jsoeterbroek/handcrank/renders/crank_arm.png

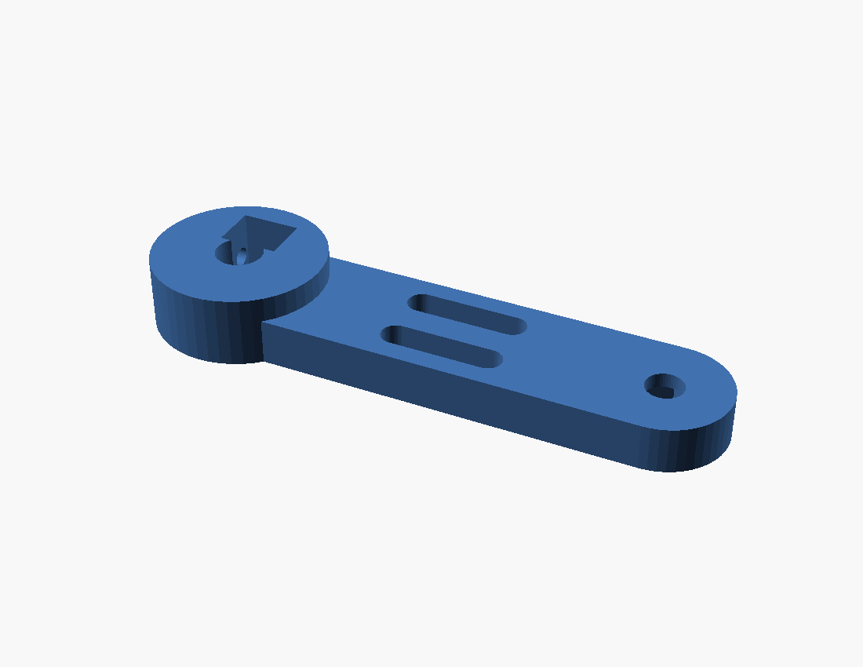
renders/crank_arm.png
