jsoeterbroek/handcrank/renders/crank_base.png

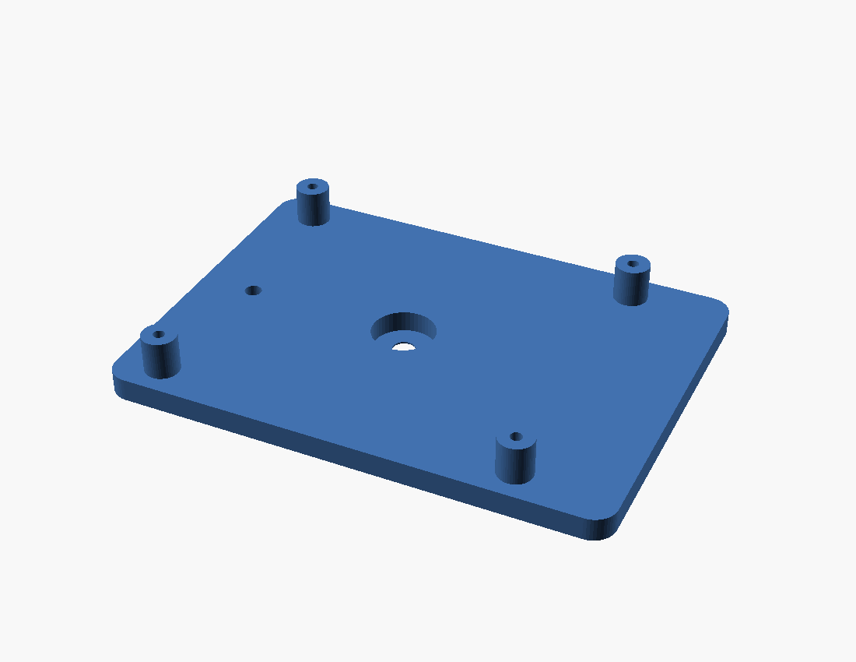
renders/crank_base.png
