jsoeterbroek/handcrank/renders/crank_gear_big.png

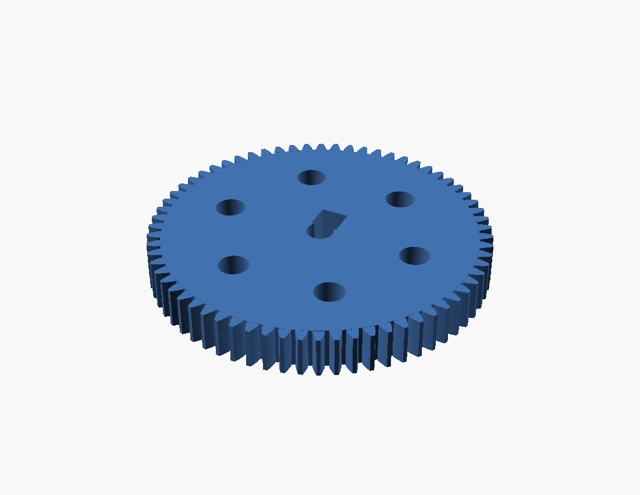
renders/crank_gear_big.png
