jsoeterbroek/handcrank/renders/crank_stator.png

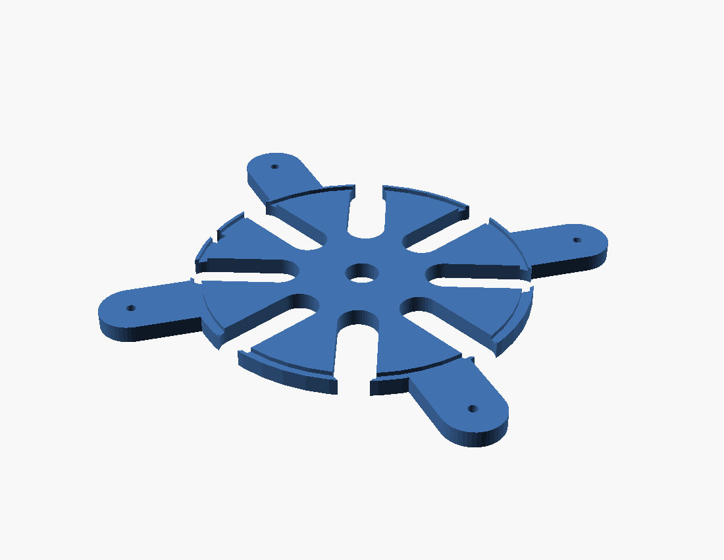
renders/crank_stator.png
