jsoeterbroek/handcrank/renders/crank_tray.png

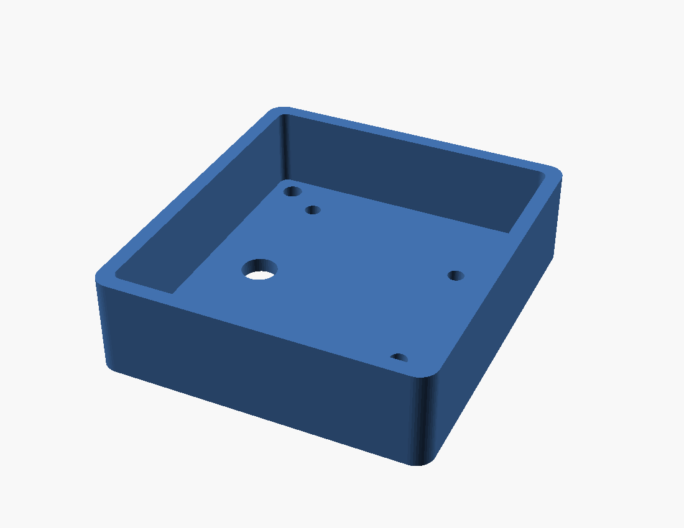
renders/crank_tray.png
