jsoeterbroek/handcrank/stl/handcrank.3mf

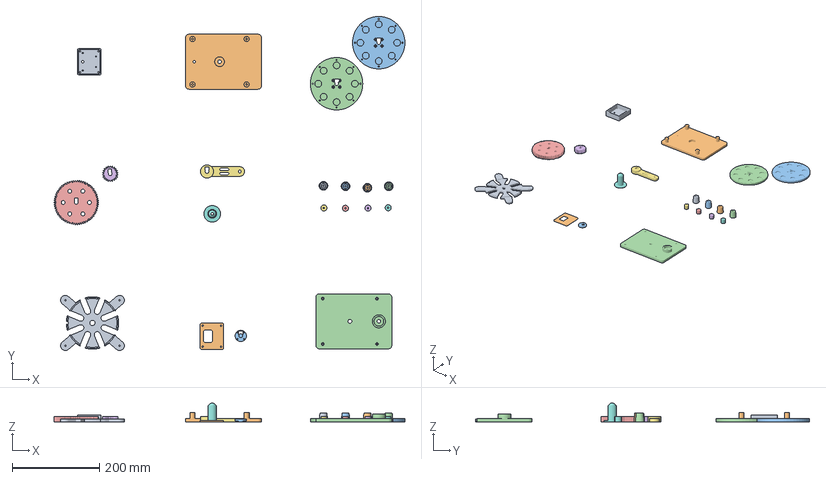
[picture p9: CAD file, 2026-10-23]
stl/handcrank.3mf
803.3 x 764.6 x 42.4 mm
crank_tray.stl
crank_base.stl
crank_rotor.stl x 2
crank_gear_big.stl
crank_gear_small.stl
crank_arm.stl
crank_knob.stl
crank_foot.stl x 4
crank_spacer.stl x 4
crank_stator.stl
crank_lid.stl
crank_hub.stl
crank_top.stl
