jsoeterbroek/handcrank/stl/crank_lid.stl

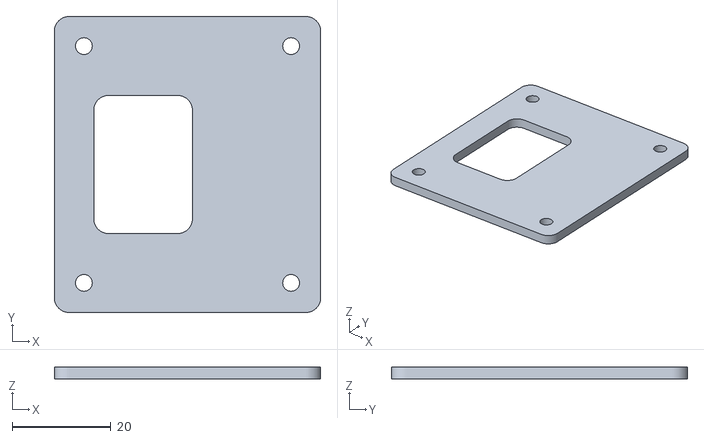
[picture p10: CAD file, 2026-10-23]
stl/crank_lid.stl
54.0 x 60.0 x 2.50
