jsoeterbroek/handcrank/stl/crank_foot.stl

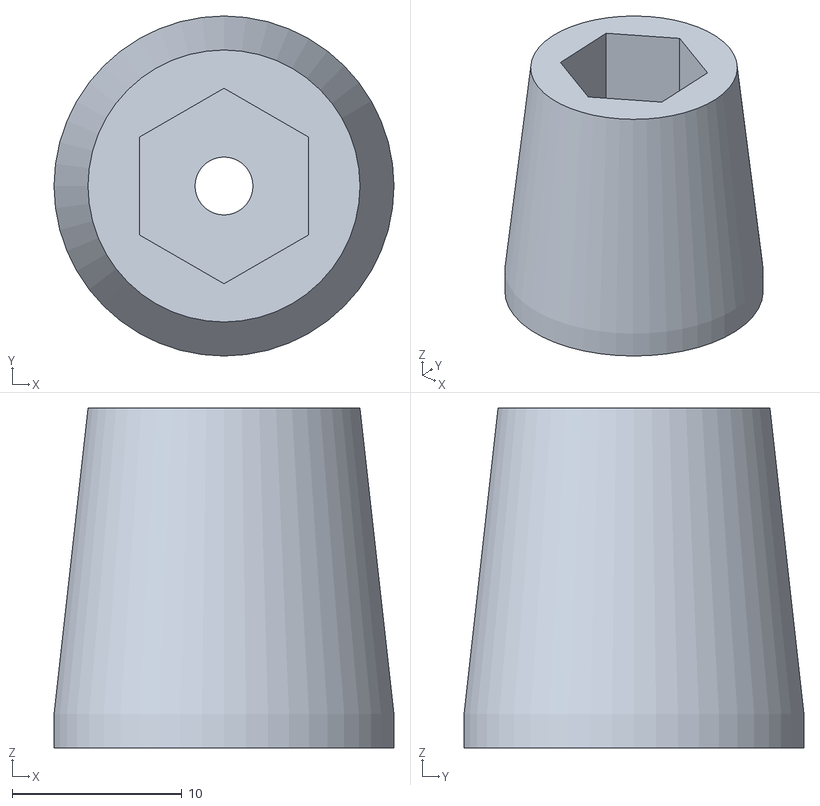
[picture p11: CAD file, 2026-10-23]
stl/crank_foot.stl
20.0 x 20.0 x 20.0
