jsoeterbroek/handcrank/stl/crank_hub.stl

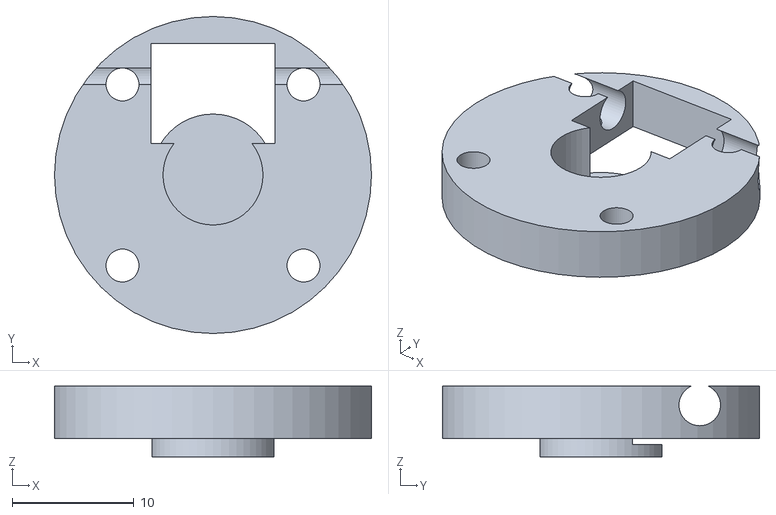
[picture p12: CAD file, 2026-10-23]
stl/crank_hub.stl
26.0 x 26.0 x 5.80
