jsoeterbroek/handcrank/stl/crank_arm.stl

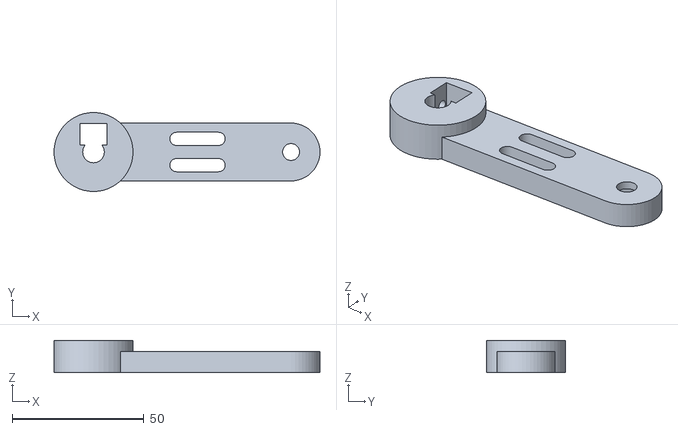
[picture p13: CAD file, 2026-10-23]
stl/crank_arm.stl
101.0 x 30.0 x 12.3
