jsoeterbroek/handcrank/stl/crank_stator.stl

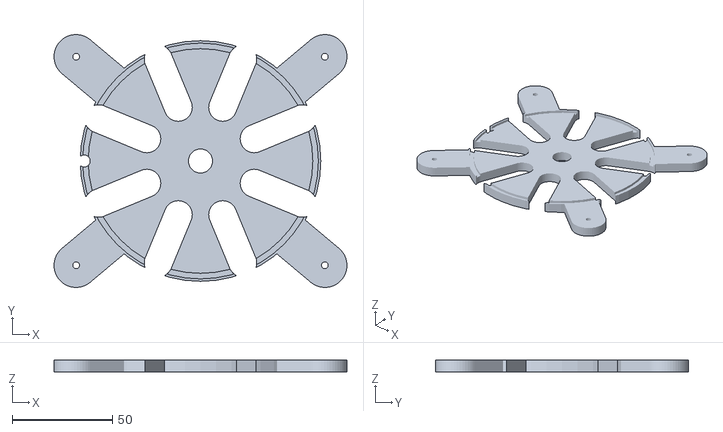
[picture p14: CAD file, 2026-10-23]
stl/crank_stator.stl
146.1 x 126.1 x 6.00
