jsoeterbroek/handcrank/stl/crank_rotor.stl

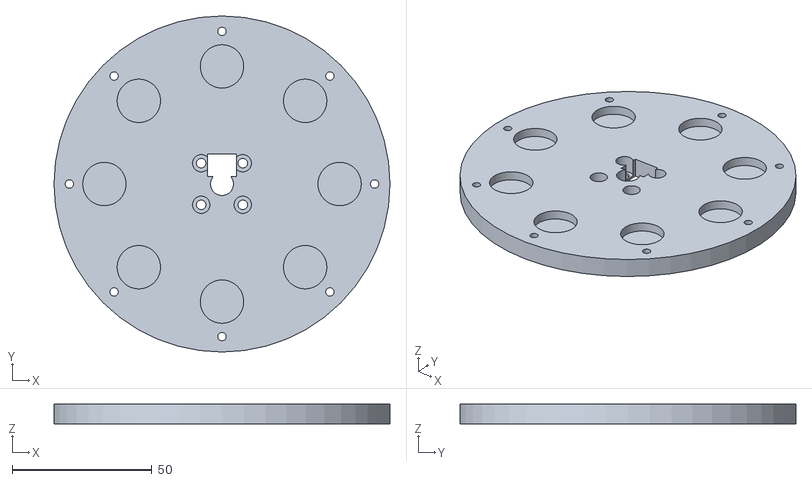
[picture p15: CAD file, 2026-10-23]
stl/crank_rotor.stl
120.0 x 120.0 x 7.00
