jsoeterbroek/handcrank/stl/crank_base.stl

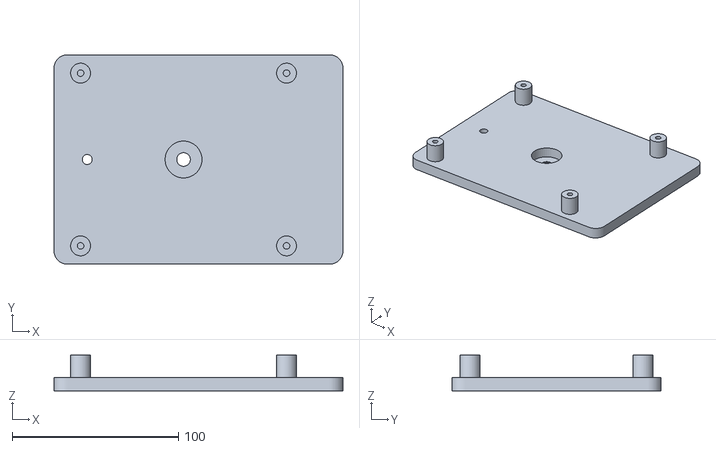
[picture p16: CAD file, 2026-10-23]
stl/crank_base.stl
174.0 x 126.0 x 21.4
