jsoeterbroek/handcrank/stl/crank_tray.stl

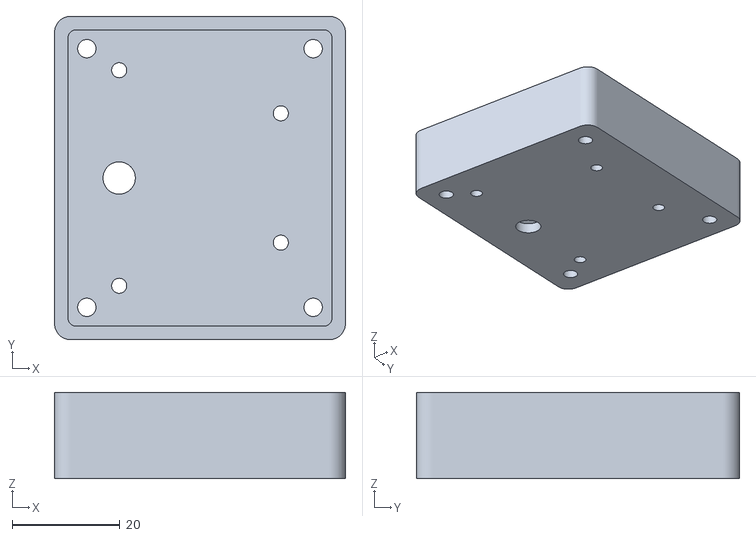
[picture p17: CAD file, 2026-10-23]
stl/crank_tray.stl
54.0 x 60.0 x 16.0
