jsoeterbroek/handcrank/stl/crank_top.stl

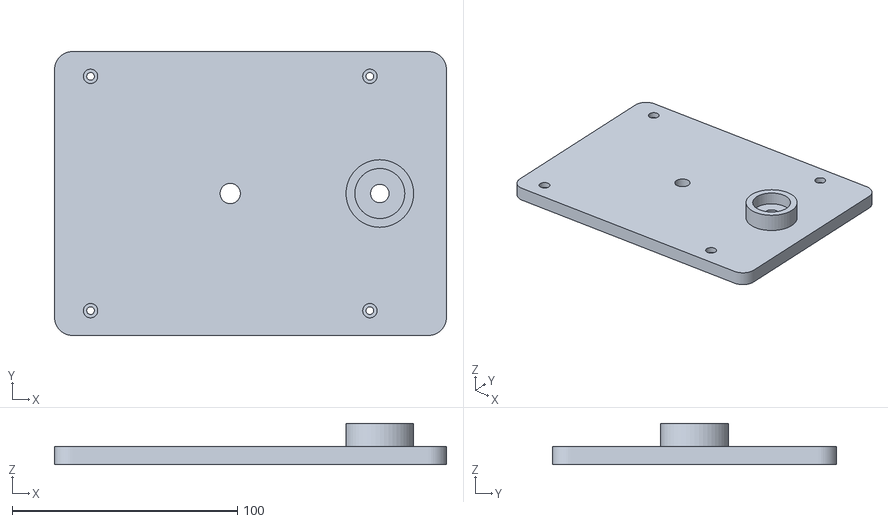
[picture p18: CAD file, 2026-10-23]
stl/crank_top.stl
174.0 x 126.0 x 18.3
