jsoeterbroek/handcrank/stl/crank_spacer.stl

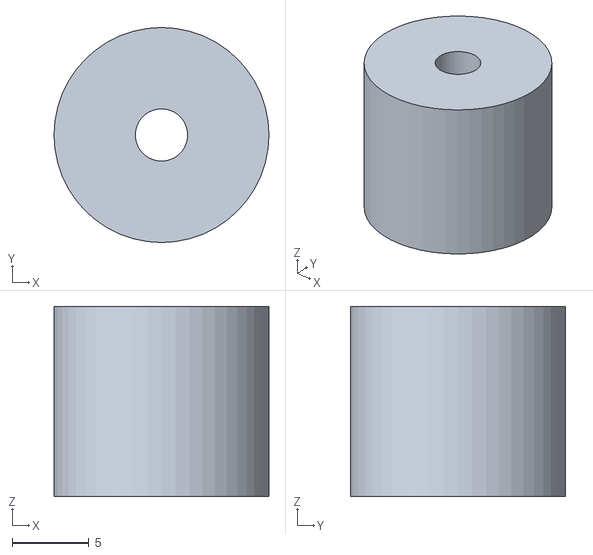
[picture p19: CAD file, 2026-10-23]
stl/crank_spacer.stl
14.0 x 14.0 x 12.4
