jsoeterbroek/handcrank/stl/crank_knob.stl

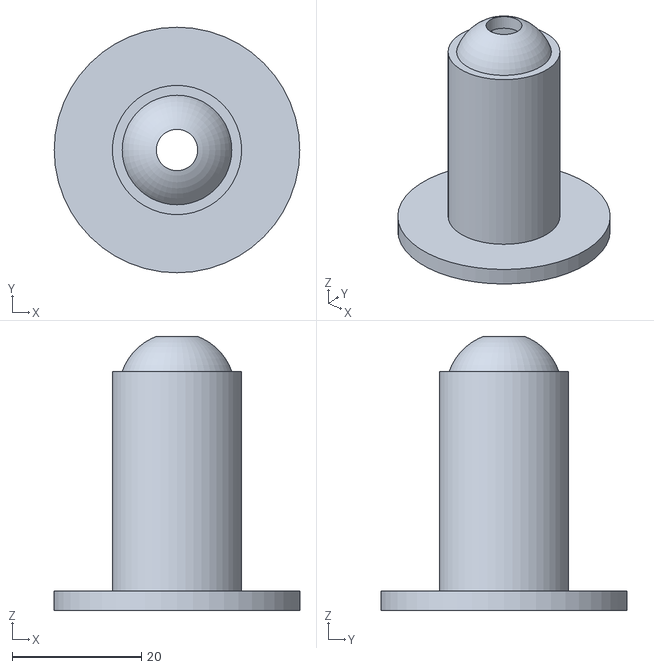
[picture p20: CAD file, 2026-10-23]
stl/crank_knob.stl
38.0 x 38.0 x 42.4
