jsoeterbroek/handcrank/stl/crank_gear_big.stl

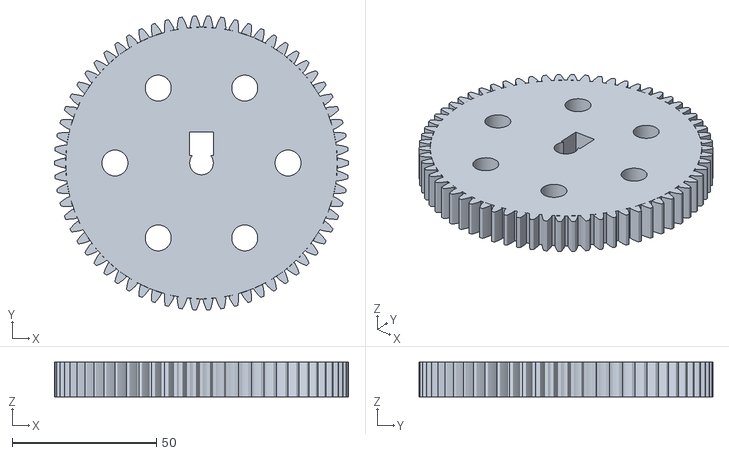
[picture p21: CAD file, 2026-10-23]
stl/crank_gear_big.stl
102.0 x 101.9 x 12.0
