jsoeterbroek/handcrank/stl/crank_gear_small.stl

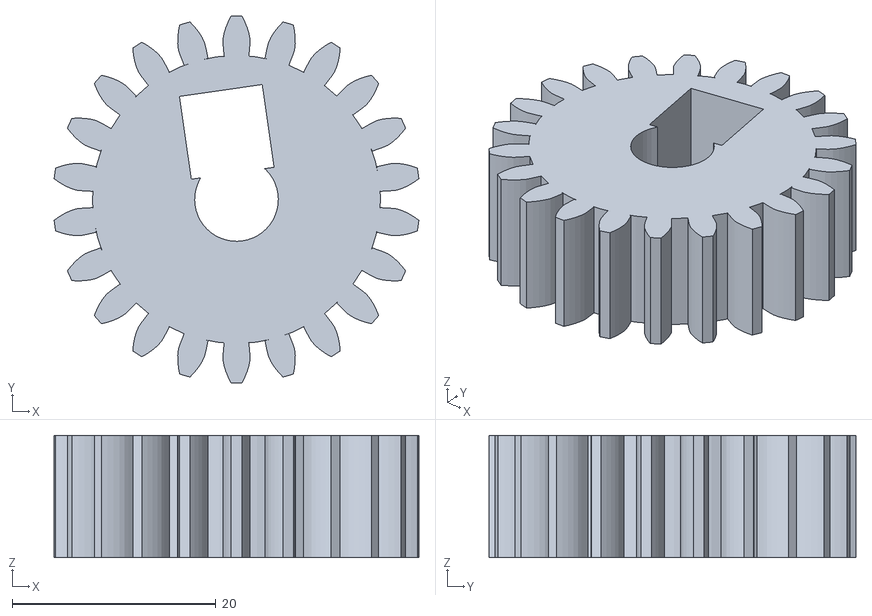
[picture p22: CAD file, 2026-10-23]
stl/crank_gear_small.stl
35.8 x 36.0 x 12.0
