jsoeterbroek/handcrank/(list of files, cad)

Other CAD files:
cad/crank_arm.scad
cad/crank_assembly.scad
cad/crank_base.scad
cad/crank_gears.scad
cad/crank_hub.scad
cad/crank_rotor.scad
cad/crank_stator.scad
cad/crank_top.scad
cad/crank_tray.scad
cad/export_crank.scad
