jsoeterbroek/handcrank/(commit log)

2026-10-18 Docs: solar plus separate hand crank generator for recharging
    Add the hand crank as a backup source sharing the solar MPPT input and
    the sealed USB-C port; track generator video transcripts.
2026-10-21 Add hand crank generator CAD (separate backup unit)
    Parametric OpenSCAD model of the 3:1 geared axial-flux hand crank
    generator, a separate unit that feeds the case's sealed USB-C charge
    port. Two 8-magnet rotors turn either side of an 8-coil stator; a
    66T:22T spur pair (1.5 mm module, 0.4 mm backlash) drives the rotor from
    the crank. Rectifier, buffer caps and a 5 V module sit in a tray under
    the base plate.
    Parts (cad/crank_*.scad, exported to stl/crank/, all manifold):
    base, stator, top, rotor (x2), hub (x2), gear_big, gear_small, arm,
    knob, tray, lid, foot (x4).
    - crank_common.scad: parameters and helpers (involute gear profile,
    D-bore, clamp hub); every z level derived from the comp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
    [crank_arm.scad, crank_arm.stl, crank_assembly.scad, crank_base.scad, crank_base.stl, crank_common.scad, crank_foot.stl, crank_gear_big.stl]
2026-10-21 Crank: fix hub screws, add spacer part, document the build order
    The assembly documentation existed but described a sequence that could
    not be built:
    - The 4 disc-to-hub screws had no head clearance: the rotor-to-stator
    gap is 0.6 mm and an M3 socket head is 3.0 mm. The rotor now has a
    6.2 mm counterbore in the magnet face, so the heads sit flush, and the
    screws go in from that face (before the stator is fitted).
    - The M6 knob nut trap opened into the arm's top face with the knob bolt
    through it; it now opens at the underside, where the nut can be held.
    - The four spacer tubes were "buy or print" with no printed part; add
    crank_spacer (the set is now 13 parts).
    - Remove a 0.2 mm s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
    [crank_arm.scad, crank_arm.stl, crank_assembly.scad, crank_base.stl, crank_common.scad, crank_foot.stl, crank_hub.scad, crank_hub.stl]
2026-10-21 Add Bambu Studio project for the crank tray and base
    Two plates on a P1S (0.20mm Strength, PLA Basic): plate 1 the
    electronics tray, plate 2 the base plate. Meshes verified identical to
    the current stl/crank/crank_tray.stl and crank_base.stl.
    [handcrank.3mf]
2026-10-22 add 3mf file
    [handcrank.3mf]
2026-10-23 Make the crank repo standalone
    Split out of the pi_flux case project (history imported), so the layout now
    assumes it is the repository root:
    - README is the crank's own document (was docs/CRANK.md), with the file table,
    commands, printed/bought parts, assembly, electrical and printing notes.
    - STLs move from stl/crank/ to stl/; export.py writes there and is called
    without the _crank suffix.
    - New cad/tools/render.py regenerates renders/crank_*.png from the STLs, so the
    repo no longer depends on the case project's render script.
    - .gitignore for the venv, reference videos and slicer output.
    All 13 parts export from this tree with bad edges: 0.
    [crank_arm.stl, crank_base.stl, crank_foot.stl, crank_gear_big.stl, crank_gear_small.stl, crank_hub.stl, crank_knob.stl, crank_lid.stl]
2026-10-23 handcrank.3mf: take the latest local Bambu project
    This is the working copy that was left uncommitted in the pi_flux tree
    (489 kB vs the 371 kB version committed there); move the newer plate layout over.
    [handcrank.3mf]
2026-10-23 extend README and add reference picture
    [handcrank.3mf]
2026-10-23 3D prints image README
2026-10-23 Use N48 disc magnets instead of N52
    Supplier stock is N48; remanence is ~4% lower, which costs ~5% alternator
    voltage and is absorbed by the 3:1 step-up and the 5V regulator. Geometry
    unchanged.
    [crank_common.scad]
